f0r4zx/proyecto-celular/docs/pantallas_simuladas.png

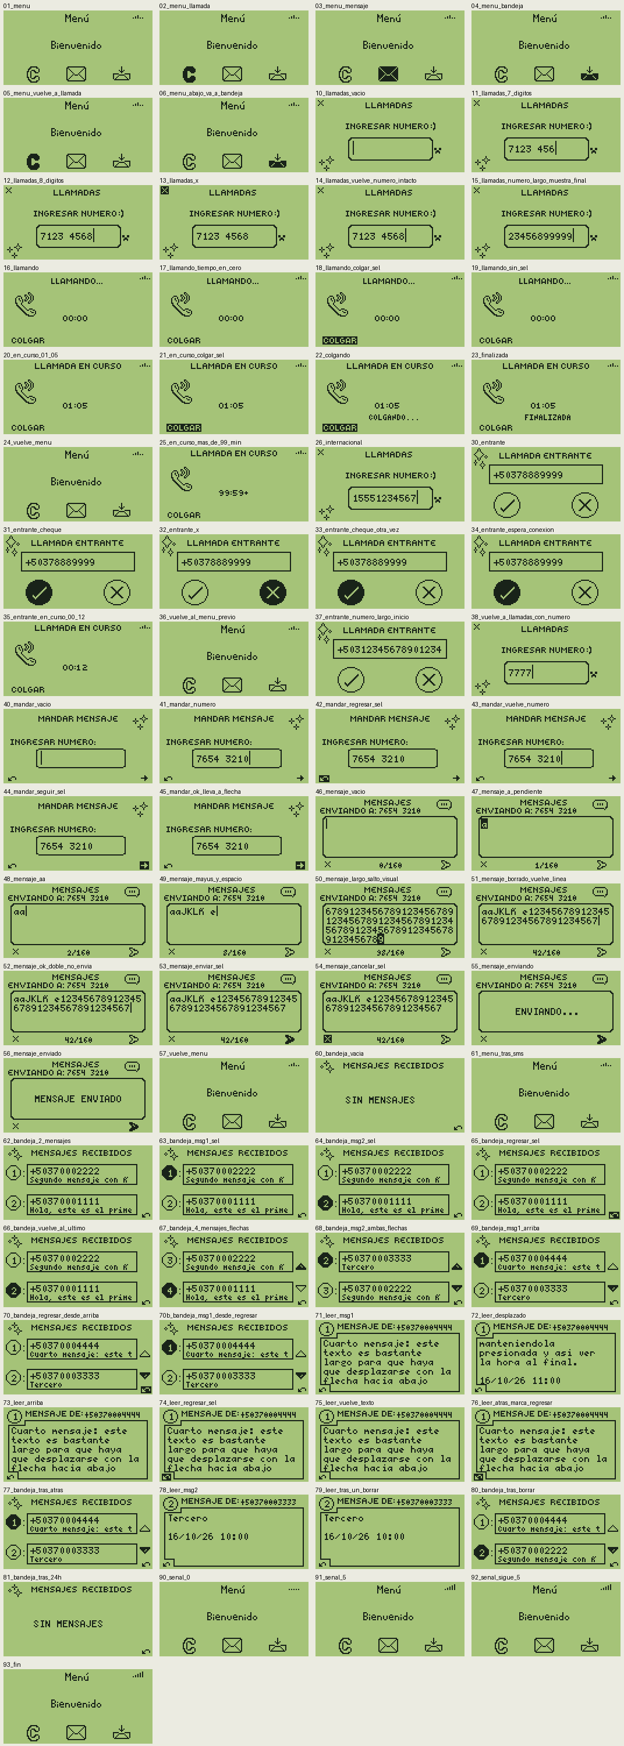
docs/pantallas_simuladas.png
