f0r4zx/proyecto-celular/firmware/esp32_interfaz/graficos.h

// =============================================================================
//  graficos.h  -  GENERADO AUTOMATICAMENTE por herramientas/generar_graficos.py
//  NO EDITAR A MANO: modificar las PNG de herramientas/pantallas_png y volver
//  a ejecutar el script. Formato XBM (U8g2 drawXBMP): filas horizontales,
//  bit 0 = pixel de la izquierda, 1 = pixel encendido (negro).
// =============================================================================
#pragma once
#include <Arduino.h>

// ------------------------------- FONDOS (128x64, parte estatica de cada menu)
// Fondo desde 01_menu_principal.png
#define FONDO_MENU_X 0   // columna donde se dibuja
#define FONDO_MENU_Y 0   // fila donde se dibuja
#define FONDO_MENU_W 128   // ancho en pixeles
#define FONDO_MENU_H 64   // alto en pixeles
static const unsigned char FONDO_MENU[] PROGMEM = {
  0x00, 0x00, 0x00, 0x00, 0x00, 0x00, 0x00, 0x00, 0x00, 0x00, 0x00, 0x00, 0x00, 0x00, 0x00, 0x00,
  0x00, 0x00, 0x00, 0x00, 0x00, 0x00, 0x00, 0x00, 0x00, 0x00, 0x00, 0x00, 0x00, 0x00, 0x00, 0x00,
  0x00, 0x00, 0x00, 0x00, 0x00, 0x00, 0x00, 0x00, 0x00, 0x00, 0x00, 0x00, 0x00, 0x00, 0x00, 0x00,
  0x00, 0x00, 0x00, 0x00, 0x00, 0x00, 0x20, 0x02, 0x00, 0x01, 0x00, 0x00, 0x00, 0x00, 0x00, 0x00,
  0x00, 0x00, 0x00, 0x00, 0x00, 0x00, 0x60, 0x03, 0x80, 0x00, 0x00, 0x00, 0x00, 0x00, 0x00, 0x00,
  0x00, 0x00, 0x00, 0x00, 0x00, 0x00, 0x60, 0x33, 0x00, 0x00, 0x00, 0x00, 0x00, 0x00, 0x00, 0x00,
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
  0x10, 0x00, 0x00, 0x00, 0x00, 0x00, 0x00, 0x00, 0x00, 0x00, 0x00, 0x00, 0x00, 0x00, 0x00, 0x08,
  0x10, 0x00, 0x00, 0x00, 0x00, 0x00, 0x00, 0x00, 0x00, 0x00, 0x00, 0x00, 0x00, 0x00, 0x00, 0x08,
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
};

// ------------------------------- PIEZAS (seleccion invertida, flechas)
// Pieza desde 02_menu_llamada_sel.png
#define SEL_MENU_LLAMADA_X 21   // columna donde se dibuja
#define SEL_MENU_LLAMADA_Y 49   // fila donde se dibuja
#define SEL_MENU_LLAMADA_W 9   // ancho en pixeles
#define SEL_MENU_LLAMADA_H 12   // alto en pixeles
static const unsigned char SEL_MENU_LLAMADA[] PROGMEM = {
  0xfe, 0x01, 0xff, 0x01, 0xff, 0x01, 0xe7, 0x01, 0xc7, 0x01, 0x07, 0x00, 0x07, 0x00, 0xc7, 0x01,
  0xe7, 0x01, 0xff, 0x01, 0xff, 0x01, 0xfe, 0x01,
};

// Pieza desde 03_menu_mensaje_sel.png
#define SEL_MENU_MENSAJE_X 55   // columna donde se dibuja
#define SEL_MENU_MENSAJE_Y 49   // fila donde se dibuja
#define SEL_MENU_MENSAJE_W 15   // ancho en pixeles
#define SEL_MENU_MENSAJE_H 11   // alto en pixeles
static const unsigned char SEL_MENU_MENSAJE[] PROGMEM = {
  0xfe, 0x3f, 0xfd, 0x5f, 0xfb, 0x6f, 0xf7, 0x77, 0xef, 0x7b, 0xdf, 0x7d, 0x2f, 0x7a, 0xf7, 0x77,
  0xfb, 0x6f, 0xfd, 0x5f, 0xfe, 0x3f,
};

// Pieza desde 04_menu_bandeja_sel.png
#define SEL_MENU_BANDEJA_X 95   // columna donde se dibuja
#define SEL_MENU_BANDEJA_Y 55   // fila donde se dibuja
#define SEL_MENU_BANDEJA_W 13   // ancho en pixeles
#define SEL_MENU_BANDEJA_H 4   // alto en pixeles
static const unsigned char SEL_MENU_BANDEJA[] PROGMEM = {
  0xff, 0x1f, 0xf7, 0x1d, 0xfb, 0x1b, 0xfd, 0x17,
};

// Pieza desde 06_llamadas_x_sel.png
#define SEL_LLAMADAS_X_X 1   // columna donde se dibuja
#define SEL_LLAMADAS_X_Y 1   // fila donde se dibuja
#define SEL_LLAMADAS_X_W 7   // ancho en pixeles
#define SEL_LLAMADAS_X_H 7   // alto en pixeles
static const unsigned char SEL_LLAMADAS_X[] PROGMEM = {
  0x7f, 0x5d, 0x6b, 0x77, 0x6b, 0x5d, 0x7f,
};

// Pieza desde 08_llamando_colgar_sel.png
#define SEL_LLAMANDO_COLGAR_X 6   // columna donde se dibuja
#define SEL_LLAMANDO_COLGAR_Y 55   // fila donde se dibuja
#define SEL_LLAMANDO_COLGAR_W 30   // ancho en pixeles
#define SEL_LLAMANDO_COLGAR_H 7   // alto en pixeles
static const unsigned char SEL_LLAMANDO_COLGAR[] PROGMEM = {
  0xff, 0xff, 0xff, 0x3f, 0x73, 0xf6, 0x9c, 0x31, 0xad, 0x75, 0x6f, 0x2d, 0xbd, 0x75, 0x69, 0x31,
  0xad, 0x75, 0x0b, 0x2d, 0x73, 0xc6, 0x6c, 0x2d, 0xff, 0xff, 0xff, 0x3f,
};

// Pieza desde 10_en_curso_colgar_sel.png
#define SEL_EN_CURSO_COLGAR_X 6   // columna donde se dibuja
#define SEL_EN_CURSO_COLGAR_Y 55   // fila donde se dibuja
#define SEL_EN_CURSO_COLGAR_W 30   // ancho en pixeles
#define SEL_EN_CURSO_COLGAR_H 7   // alto en pixeles
static const unsigned char SEL_EN_CURSO_COLGAR[] PROGMEM = {
  0xff, 0xff, 0xff, 0x3f, 0x73, 0xf6, 0x9c, 0x31, 0xad, 0x75, 0x6f, 0x2d, 0xbd, 0x75, 0x69, 0x31,
  0xad, 0x75, 0x0b, 0x2d, 0x73, 0xc6, 0x6c, 0x2d, 0xff, 0xff, 0xff, 0x3f,
};

// Pieza desde 12_entrante_contestar_sel.png
#define SEL_ENTRANTE_CONTESTAR_X 20   // columna donde se dibuja
#define SEL_ENTRANTE_CONTESTAR_Y 40   // fila donde se dibuja
#define SEL_ENTRANTE_CONTESTAR_W 21   // ancho en pixeles
#define SEL_ENTRANTE_CONTESTAR_H 20   // alto en pixeles
static const unsigned char SEL_ENTRANTE_CONTESTAR[] PROGMEM = {
  0xe0, 0xff, 0x00, 0xf8, 0xff, 0x03, 0xfc, 0xff, 0x07, 0xfe, 0xff, 0x0f, 0xfe, 0xff, 0x0f, 0xff,
  0xff, 0x1e, 0xff, 0x7f, 0x1e, 0xff, 0x3f, 0x1f, 0xff, 0x9f, 0x1f, 0xff, 0xcf, 0x1f, 0xff, 0xe7,
  0x1f, 0xff, 0xf3, 0x1f, 0xdf, 0xf9, 0x1f, 0x9f, 0xfc, 0x1f, 0x3f, 0xfe, 0x1f, 0x7e, 0xff, 0x0f,
  0xfe, 0xff, 0x0f, 0xfc, 0xff, 0x07, 0xf8, 0xff, 0x03, 0xe0, 0xff, 0x00,
};

// Pieza desde 13_entrante_rechazar_sel.png
#define SEL_ENTRANTE_RECHAZAR_X 87   // columna donde se dibuja
#define SEL_ENTRANTE_RECHAZAR_Y 40   // fila donde se dibuja
#define SEL_ENTRANTE_RECHAZAR_W 21   // ancho en pixeles
#define SEL_ENTRANTE_RECHAZAR_H 20   // alto en pixeles
static const unsigned char SEL_ENTRANTE_RECHAZAR[] PROGMEM = {
  0xe0, 0xff, 0x00, 0xf8, 0xff, 0x03, 0xfc, 0xff, 0x07, 0xfe, 0xff, 0x0f, 0xfe, 0xff, 0x0f, 0x9f,
  0x3f, 0x1f, 0x3f, 0x9f, 0x1f, 0x7f, 0xce, 0x1f, 0xff, 0xe4, 0x1f, 0xff, 0xf1, 0x1f, 0xff, 0xf1,
  0x1f, 0xff, 0xe4, 0x1f, 0x7f, 0xce, 0x1f, 0x3f, 0x9f, 0x1f, 0x9f, 0x3f, 0x1f, 0xfe, 0xff, 0x0f,
  0xfe, 0xff, 0x0f, 0xfc, 0xff, 0x07, 0xf8, 0xff, 0x03, 0xe0, 0xff, 0x00,
};

// Pieza desde 15_mandar_regresar_sel.png
#define SEL_MANDAR_REGRESAR_X 3   // columna donde se dibuja
#define SEL_MANDAR_REGRESAR_Y 57   // fila donde se dibuja
#define SEL_MANDAR_REGRESAR_W 9   // ancho en pixeles
#define SEL_MANDAR_REGRESAR_H 6   // alto en pixeles
static const unsigned char SEL_MANDAR_REGRESAR[] PROGMEM = {
  0xff, 0x01, 0x8f, 0x01, 0x75, 0x01, 0x79, 0x01, 0xf1, 0x01, 0xff, 0x01,
};

// Pieza desde 16_mandar_seguir_sel.png
#define SEL_MANDAR_SEGUIR_X 117   // columna donde se dibuja
#define SEL_MANDAR_SEGUIR_Y 56   // fila donde se dibuja
#define SEL_MANDAR_SEGUIR_W 8   // ancho en pixeles
#define SEL_MANDAR_SEGUIR_H 7   // alto en pixeles
static const unsigned char SEL_MANDAR_SEGUIR[] PROGMEM = {
  0xff, 0xef, 0xcf, 0x81, 0xcf, 0xef, 0xff,
};

// Pieza desde 18_mensaje_enviar_sel.png
#define SEL_MENSAJE_ENVIAR_X 109   // columna donde se dibuja
#define SEL_MENSAJE_ENVIAR_Y 56   // fila donde se dibuja
#define SEL_MENSAJE_ENVIAR_W 6   // ancho en pixeles
#define SEL_MENSAJE_ENVIAR_H 6   // alto en pixeles
static const unsigned char SEL_MENSAJE_ENVIAR[] PROGMEM = {
  0x0f, 0x3b, 0x36, 0x3e, 0x3f, 0x0f,
};

// Pieza desde 19_mensaje_cancelar_sel.png
#define SEL_MENSAJE_CANCELAR_X 7   // columna donde se dibuja
#define SEL_MENSAJE_CANCELAR_Y 55   // fila donde se dibuja
#define SEL_MENSAJE_CANCELAR_W 7   // ancho en pixeles
#define SEL_MENSAJE_CANCELAR_H 7   // alto en pixeles
static const unsigned char SEL_MENSAJE_CANCELAR[] PROGMEM = {
  0x7f, 0x5d, 0x6b, 0x77, 0x6b, 0x5d, 0x7f,
};

// Pieza desde 21_bandeja_regresar_sel.png
#define SEL_BANDEJA_REGRESAR_X 118   // columna donde se dibuja
#define SEL_BANDEJA_REGRESAR_Y 57   // fila donde se dibuja
#define SEL_BANDEJA_REGRESAR_W 9   // ancho en pixeles
#define SEL_BANDEJA_REGRESAR_H 6   // alto en pixeles
static const unsigned char SEL_BANDEJA_REGRESAR[] PROGMEM = {
  0xff, 0x01, 0x8f, 0x01, 0x75, 0x01, 0x79, 0x01, 0xf1, 0x01, 0xff, 0x01,
};

// Pieza desde 28_leer_msg1_regresar_sel.png
#define SEL_LEER_REGRESAR_X 2   // columna donde se dibuja
#define SEL_LEER_REGRESAR_Y 57   // fila donde se dibuja
#define SEL_LEER_REGRESAR_W 8   // ancho en pixeles
#define SEL_LEER_REGRESAR_H 6   // alto en pixeles
static const unsigned char SEL_LEER_REGRESAR[] PROGMEM = {
  0xff, 0xcf, 0xb5, 0xb9, 0xf1, 0xff,
};

// Pieza desde 25_bandeja_subir.png
#define FLECHA_ARRIBA_X 117   // columna donde se dibuja
#define FLECHA_ARRIBA_Y 26   // fila donde se dibuja
#define FLECHA_ARRIBA_W 9   // ancho en pixeles
#define FLECHA_ARRIBA_H 6   // alto en pixeles
static const unsigned char FLECHA_ARRIBA[] PROGMEM = {
  0x10, 0x00, 0x28, 0x00, 0x44, 0x00, 0x82, 0x00, 0x01, 0x01, 0xff, 0x01,
};

// Pieza desde 26_bandeja_subir_sel.png
#define FLECHA_ARRIBA_ACTIVA_X 117   // columna donde se dibuja
#define FLECHA_ARRIBA_ACTIVA_Y 26   // fila donde se dibuja
#define FLECHA_ARRIBA_ACTIVA_W 9   // ancho en pixeles
#define FLECHA_ARRIBA_ACTIVA_H 6   // alto en pixeles
static const unsigned char FLECHA_ARRIBA_ACTIVA[] PROGMEM = {
  0x10, 0x00, 0x38, 0x00, 0x6c, 0x00, 0xde, 0x00, 0xff, 0x01, 0xff, 0x01,
};

// Pieza desde 23_bandeja_mas_abajo.png
#define FLECHA_ABAJO_X 117   // columna donde se dibuja
#define FLECHA_ABAJO_Y 45   // fila donde se dibuja
#define FLECHA_ABAJO_W 9   // ancho en pixeles
#define FLECHA_ABAJO_H 6   // alto en pixeles
static const unsigned char FLECHA_ABAJO[] PROGMEM = {
  0xff, 0x01, 0x01, 0x01, 0x82, 0x00, 0x44, 0x00, 0x28, 0x00, 0x10, 0x00,
};

// Pieza desde 24_bandeja_abajo_sel.png
#define FLECHA_ABAJO_ACTIVA_X 117   // columna donde se dibuja
#define FLECHA_ABAJO_ACTIVA_Y 45   // fila donde se dibuja
#define FLECHA_ABAJO_ACTIVA_W 9   // ancho en pixeles
#define FLECHA_ABAJO_ACTIVA_H 6   // alto en pixeles
static const unsigned char FLECHA_ABAJO_ACTIVA[] PROGMEM = {
  0xff, 0x01, 0xff, 0x01, 0xde, 0x00, 0x6c, 0x00, 0x38, 0x00, 0x10, 0x00,
};

// ------------------------------- CIRCULOS NUMERADOS (el numero lo pone el codigo)
// Circulo desde 20_bandeja.png
#define CIRCULO_BANDEJA_X 2   // columna donde se dibuja
#define CIRCULO_BANDEJA_Y 17   // fila donde se dibuja
#define CIRCULO_BANDEJA_W 13   // ancho en pixeles
#define CIRCULO_BANDEJA_H 13   // alto en pixeles
static const unsigned char CIRCULO_BANDEJA[] PROGMEM = {
  0xf0, 0x01, 0x08, 0x02, 0x04, 0x04, 0x02, 0x08, 0x01, 0x10, 0x01, 0x10, 0x01, 0x10, 0x01, 0x10,
  0x01, 0x10, 0x02, 0x08, 0x04, 0x04, 0x08, 0x02, 0xf0, 0x01,
};

// Circulo desde 20_bandeja.png
#define CIRCULO_BANDEJA_LLENO_X 2   // columna donde se dibuja
#define CIRCULO_BANDEJA_LLENO_Y 17   // fila donde se dibuja
#define CIRCULO_BANDEJA_LLENO_W 13   // ancho en pixeles
#define CIRCULO_BANDEJA_LLENO_H 13   // alto en pixeles
static const unsigned char CIRCULO_BANDEJA_LLENO[] PROGMEM = {
  0xf0, 0x01, 0xf8, 0x03, 0xfc, 0x07, 0xfe, 0x0f, 0xff, 0x1f, 0xff, 0x1f, 0xff, 0x1f, 0xff, 0x1f,
  0xff, 0x1f, 0xfe, 0x0f, 0xfc, 0x07, 0xf8, 0x03, 0xf0, 0x01,
};

// Circulo desde 27_leer_msg1.png
#define CIRCULO_LEER_X 3   // columna donde se dibuja
#define CIRCULO_LEER_Y 2   // fila donde se dibuja
#define CIRCULO_LEER_W 13   // ancho en pixeles
#define CIRCULO_LEER_H 12   // alto en pixeles
static const unsigned char CIRCULO_LEER[] PROGMEM = {
  0xf0, 0x01, 0x0c, 0x06, 0x02, 0x08, 0x02, 0x08, 0x01, 0x10, 0x01, 0x10, 0x01, 0x10, 0x01, 0x10,
  0x02, 0x08, 0x02, 0x08, 0x0c, 0x06, 0xf0, 0x01,
};
