f0r4zx/proyecto-celular/(commit log)

2026-10-16 Programa integrado del celular básico (ESP32 + Arduino Uno + SIM900)
    - ESP32: teclado matricial con antirrebote, menús completos (llamadas,
    llamada entrante, mandar mensaje, mensajes, bandeja, leer), escritura
    multi-toque, cronómetro de llamada, bandeja con borrado a las 24 h y
    dibujo en la LCD12864 (ST7920) con envío solo de las zonas que cambian.
    - Arduino Uno: mediador AT no bloqueante para la SIM900 (llamar, colgar,
    contestar, rechazar, SMS con ñ/tildes GSM y UCS2, señal 0-5 con registro
    en red, volumen fijo 80 %, micrófono abierto, encendido por D9).
    - Enlace UART con checksum, ACK y reintentos entre ambas placas.
    - Gráficos generados desde las 31 pantallas del diseño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
2026-10-16 Diagrama de conexiones de todas las placas y componentes
    Claude-Session: https://claude.ai/code/session_015etdv9i8dmePtdBuuEajPk
2026-10-22 Prueba de llamada automatica con codigos de error en el LED
    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
    [prueba_llamada.ino]
